gotlate/Smart_Assistive_Stick/(commit log)

2025-07-03 Flame Sensor Demo
2025-07-03 Gas Sensor Demo
2025-07-03 Tilt Sensor Demo
2025-07-03 Water Sensor Demo
2025-07-03 Ultrasonic Sensors Demo
